Zoev89/Draaischijf/StepperDriver/Pololu - A4988 Stepper Motor Driver Carrier_files/0J4577.300.jpg

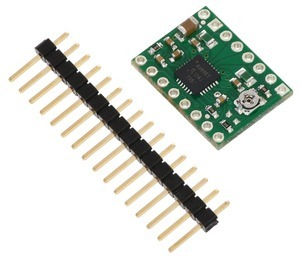
StepperDriver/Pololu - A4988 Stepper Motor Driver Carrier_files/0J4577.300.jpg
