Zoev89/Draaischijf/StepperDriver/Pololu - A4988 Stepper Motor Driver Carrier_files/0J1418.250.jpg

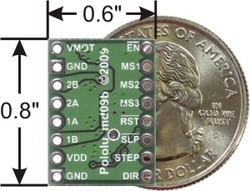
StepperDriver/Pololu - A4988 Stepper Motor Driver Carrier_files/0J1418.250.jpg
