Zoev89/Draaischijf/StepperDriver/Pololu - A4988 Stepper Motor Driver Carrier_files/0J4578.180.jpg

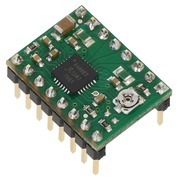
StepperDriver/Pololu - A4988 Stepper Motor Driver Carrier_files/0J4578.180.jpg
