Zoev89/Draaischijf/huis.stl

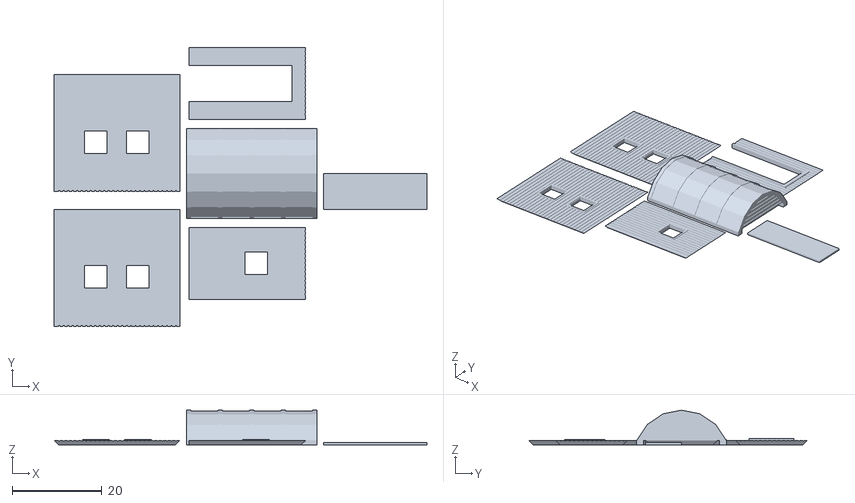
[picture p4: CAD file, 2016-03-12]
huis.stl
83.0 x 62.0 x 7.70
