Zoev89/Draaischijf/onderkant.stl

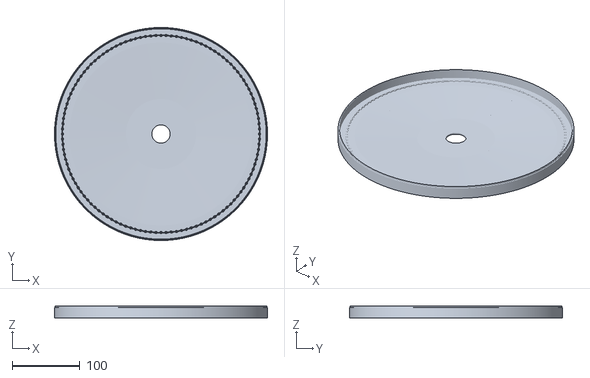
[picture p5: CAD file, 2016-03-12]
onderkant.stl
314.0 x 314.0 x 17.0
