Zoev89/Draaischijf/trap.stl

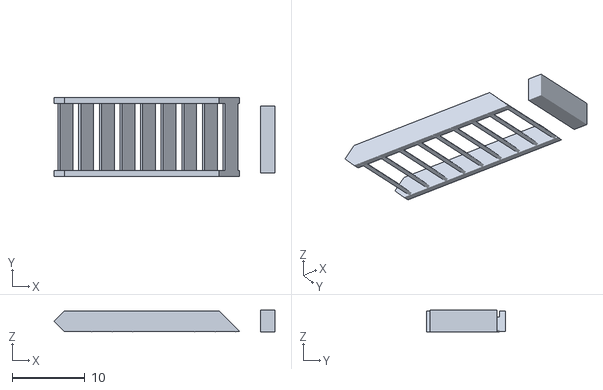
[picture p6: CAD file, 2016-03-12]
trap.stl
30.3 x 10.8 x 3.00
