Zoev89/Draaischijf/groteTandwiel.stl

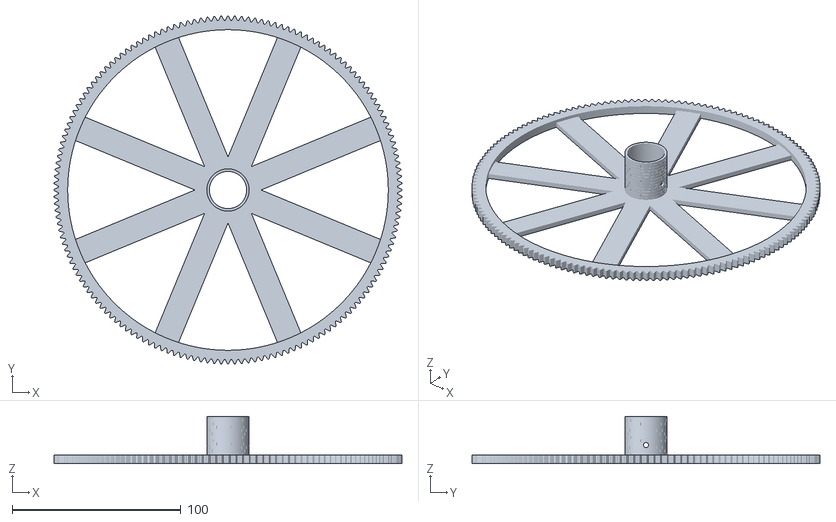
[picture p7: CAD file, 2016-03-12]
groteTandwiel.stl
206.3 x 206.3 x 28.0
