Zoev89/Draaischijf/platformRails.stl

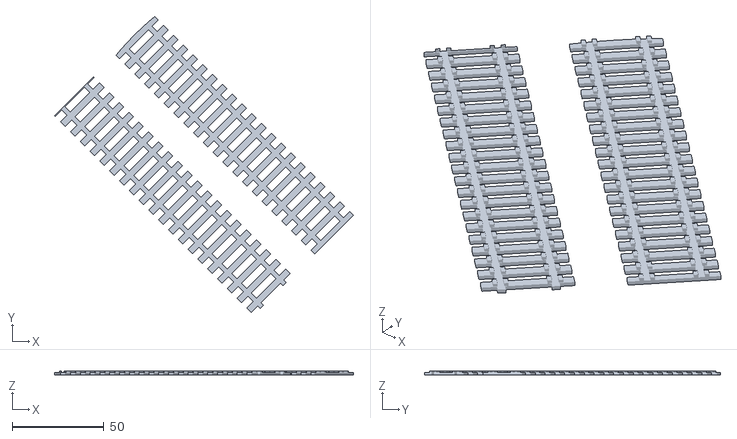
[picture p8: CAD file, 2016-03-12]
platformRails.stl
163.1 x 161.5 x 2.30
