Zoev89/Draaischijf/groteLigger.stl

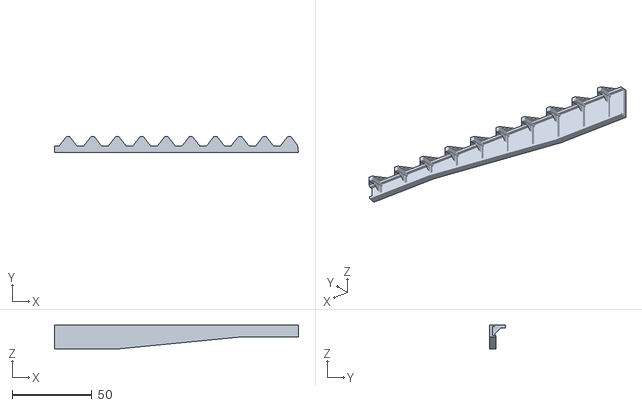
[picture p9: CAD file, 2016-03-12]
groteLigger.stl
152.9 x 10.0 x 15.0
