Zoev89/Draaischijf/motorSteun.stl

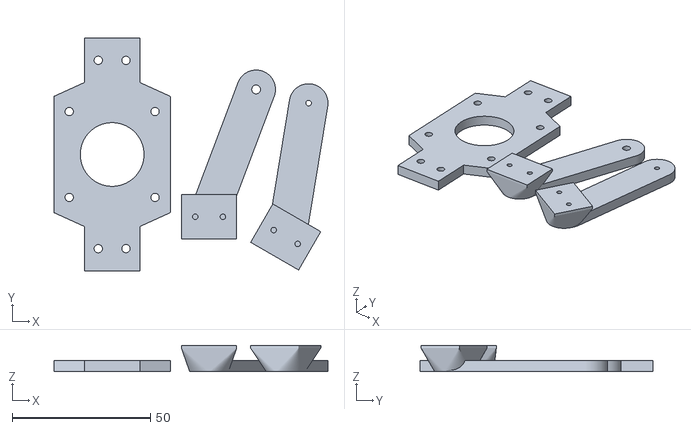
[picture p10: CAD file, 2016-03-12]
motorSteun.stl
99.0 x 84.0 x 9.50
