Zoev89/Draaischijf/tandKlem.stl

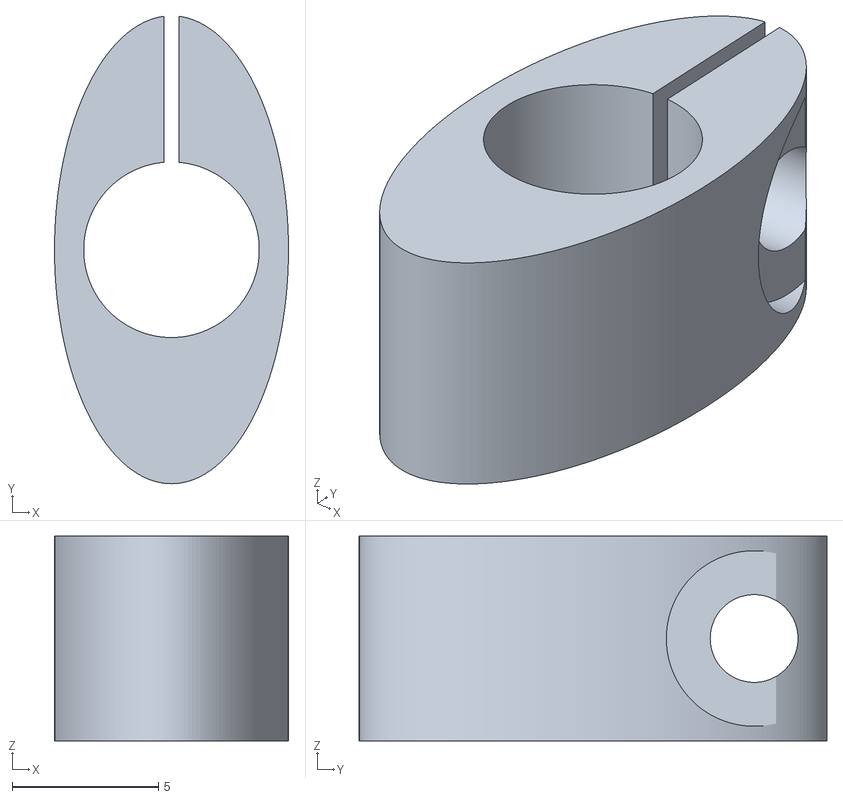
[picture p11: CAD file, 2016-03-12]
tandKlem.stl
8.00 x 16.0 x 7.00
