Zoev89/Draaischijf/steuntjes.stl

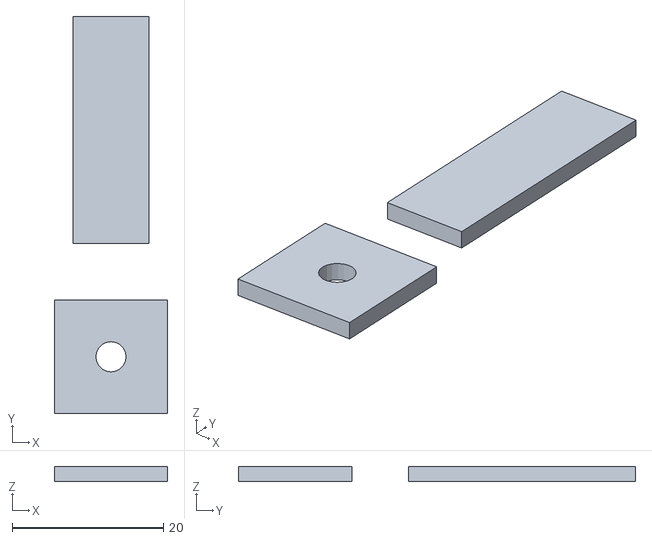
[picture p12: CAD file, 2016-03-12]
steuntjes.stl
15.0 x 52.5 x 2.00
