Zoev89/Draaischijf/pootjes.stl

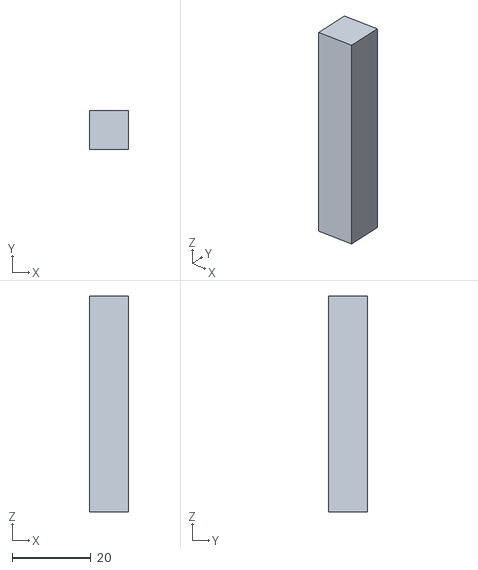
[picture p13: CAD file, 2016-03-12]
pootjes.stl
10.0 x 10.0 x 55.0
