Zoev89/Draaischijf/onderPlaat.stl

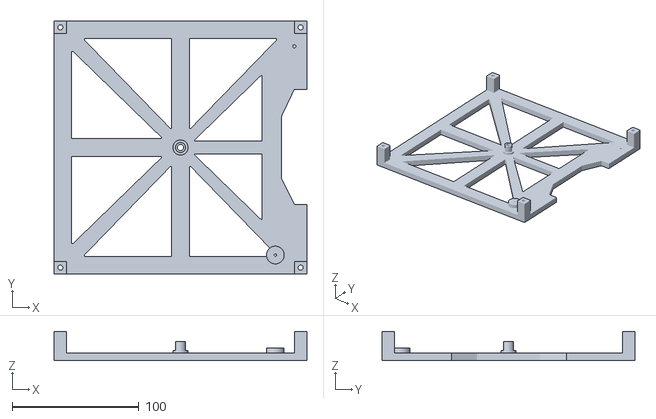
[picture p14: CAD file, 2016-03-12]
onderPlaat.stl
200.0 x 200.0 x 23.0
