Zoev89/Draaischijf/railsDeksel.stl

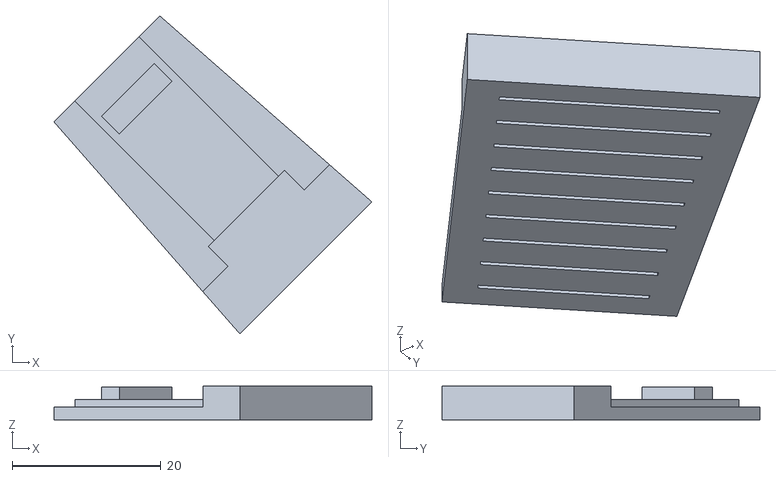
[picture p15: CAD file, 2016-03-12]
railsDeksel.stl
42.7 x 42.7 x 4.50
