Zoev89/Draaischijf/binnenkant.stl

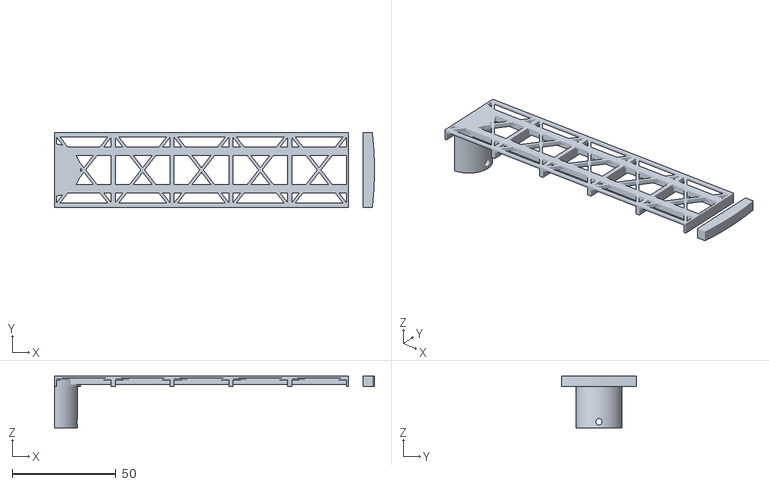
[picture p16: CAD file, 2016-03-12]
binnenkant.stl
154.0 x 36.0 x 25.0
