Zoev89/Draaischijf/BevestigingsRing.stl

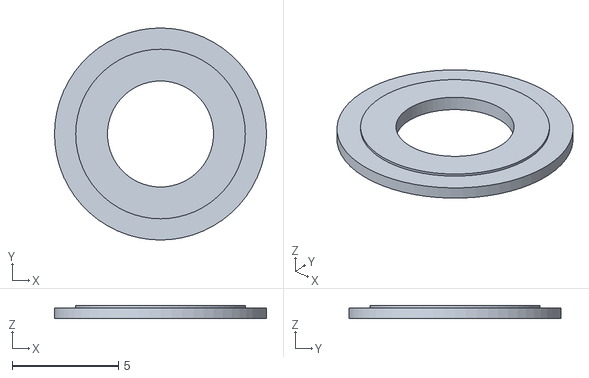
[picture p17: CAD file, 2016-03-12]
BevestigingsRing.stl
10.0 x 10.0 x 0.6
