Zoev89/Draaischijf/railing.stl

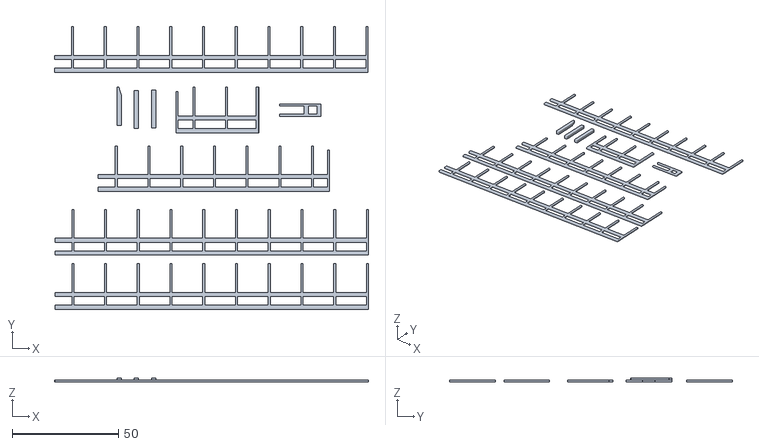
[picture p18: CAD file, 2016-03-12]
railing.stl
147.7 x 133.0 x 2.00
