Zoev89/Draaischijf/kleineTandwiel.stl

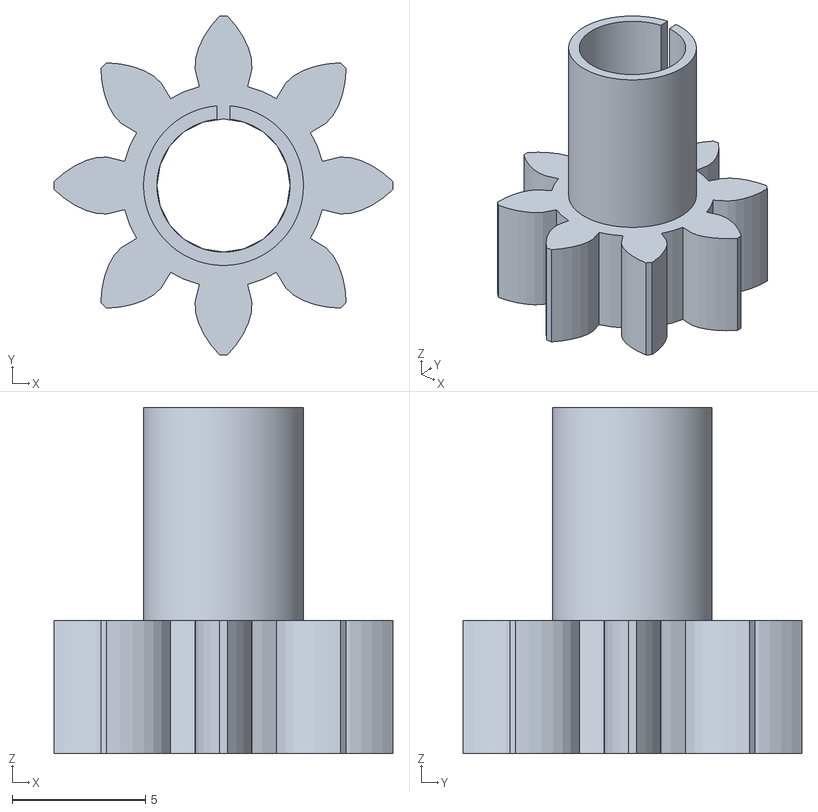
[picture p19: CAD file, 2016-03-12]
kleineTandwiel.stl
12.7 x 12.7 x 13.0
