Zoev89/Draaischijf/bodemPlanken.stl

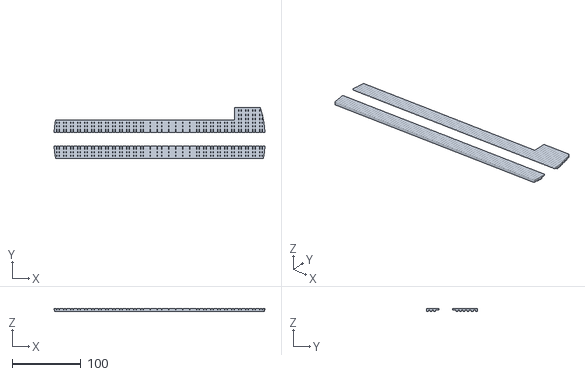
[picture p20: CAD file, 2016-03-12]
bodemPlanken.stl
307.3 x 74.0 x 4.00
