Zoev89/Draaischijf/railsAansluiting.stl

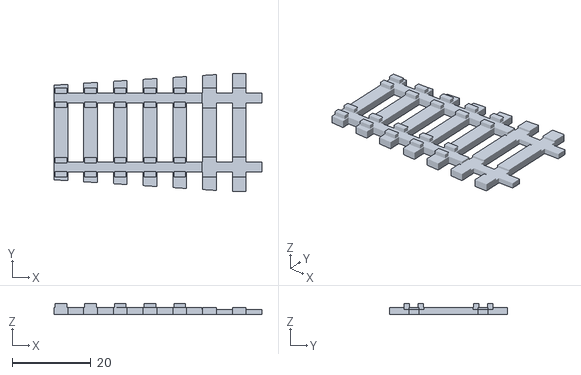
[picture p21: CAD file, 2016-03-12]
railsAansluiting.stl
52.9 x 30.0 x 2.80
