Zoev89/Draaischijf/(threads)

Thread 1 (2023-10-13):

Turntable

derDoc2023, 2023-10-13:
Hello,
The turntable is interesting.

What length of locomotive can be parked there?

Zoev89, 2023-10-14:
The length is 30.5mm. The locomotive could be larger but its weels must fit withing the 30.5mm otherwise it can not turn.

derDoc2023, 2023-10-16:
Thanks for the info. It's a nice template. Unfortunately, many things don't fit on my print bed. And since I don't really know much about OPENCAD, it's a bit difficult. I already have your locomotive shed in print. Also a wonderful template!

Are all round parts also available as 1/4 parts?

Zoev89, 2023-10-16:
The big bottom part is in 4 parts. My printer bed can not hold 30cm part. I have a ultimaker orgininal and its bed is a little over 20cm. Max 21cm if I am not wrong.

derDoc2023, 2023-10-17:
Hey,

I have an Ender V3 Neo, the print bed is 25cm. I also found the file with the quarter pieces. But I can't print it like that. Because neither my Crealty Slicer nor Cura deletes the other parts.

Because I think your design is really great and would really like to use it.

I've already printed your engine shed. It's also great and can be used modularly.

Zoev89, 2023-10-17:
In the source file you can comment out any part that you don't want to
print at that time. Select one part generate the stl and print. With a
printer bed of 25cm you can do it. Mine is smaller:)

Op di 17 okt. 2023 05:57 schreef derDoc2023 ***@***.***>:

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

derDoc2023, 2023-10-17:
Thank you!

I'm such an idiot for not seeing that.

But one more thing, do you have instructions on how exactly you put something together? Because some things are not entirely clear to me.

Unfortunately there is nothing in the download.

I will control the turntable with an Arduino. I would be happy to send you a little information about how I did it and I can send you photos if you want.

Greetings from Bischofswerda

Zoev89, 2023-10-18:
Did you also see the images on youmagine?

[https://www.youmagine.com/designs/h0-train-turntable](url)

What do you mean by the download. All the files are here on the github.
In the electronics I used a atmega8 which is actually the same chip to be found on some of the ardruino's. For the steppenmotor driver I used the baseclock of my railway electronics which is a 28000 baudrate from the uart. So there you have to create something yourself. You can also use a simple clock and readin some input lines to form the position and then let it run to that position. Could be as simple as that. In my case the turntable also provides the power for the track that is in the locomotive shed.

Zoev89, 2023-10-18:
Did you also found this site:
[https://zoev89.github.io/draaiSchijf/index.html](url)
Sort of the same info but there are some extra fotoos.

Greetings from Waalre

derDoc2023, 2023-10-19:
Good morning,

// -> What do you mean by download? All files are here on Github.
I found the print template via https://thangs.com/search/h0?scope=all.

I plan to control the turntable via an Arduino. Offers itself. I will probably solve the approach to the positions with reed contacts and a magnet. I have to test it.

In the photos you solved it with cables on the king chair. I try to design the rotation movement so that I don't have to pay attention to the cables. Because these can also become over-tightened and defective at some point. I test the whole thing with Holplugs and sockets. Since I drive digitally and the amps also have to run through the plugs.

-> https://www.amazon.de/RUNCCI-YUN-DC-Hohlstecker-L%C3%B6tleitung-DC-Stecker%EF%BC%88Mit-%C3%9Cberwachungskameras/dp/B0836N82PR/

What did you use to solve the king chair running on the base plate? What kind of wheels are these, with or without ball bearings and where can I get them? I did a search, but I needed the diameter of the wheels.

Zoev89, 2023-10-21:
The wheels are small bearings but I did not specify the size. I looked in
the scad files and it turns out to be 8mm diameter and 3mm inner dia.

Actually I never posted on thangs.com so that is maybe why the download is
not complete.

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
