Zoev89/Draaischijf/DraaiBoard/DraaiBoard.sch

## KiCad design DraaiBoard/DraaiBoard.sch (2016-04-03)

Schematic: DraaiBoard.sch

Parts:
C1, C2: 22pF
C3: 100uF
C4: 100nF
D1, D2, D3, D4: ZENER 2V7
D5, D6, D7, D8, D9, D10, D11, D12, D13, D14: DIODE
IC1: ATMEGA8A-P; DIL28
J1: DB25
K1, K2, K3, K4, K5, K6, K7, K8, K9: RELAY_2RT
P1: CONN_5X2
Q1: BD680; TO220
Q2: BD679; TO220
Q3, Q5, Q7, Q8, Q9, Q10, Q11, Q12, Q13, Q14, Q15: BC546; TO92
Q4, Q6: BC556; TO92
R1, R2: 0.39
R3, R6: 33K
R4: 132E
R5: 100K
R7, R9, R11, R12, R13, R14, R15, R16, R17, R18, R19, R20, R21, R22, R23, R25, R26, R27: 10K
R8: 8k2
R10: 100E
R24: 2.2K
R28: 1K
U1: 7805
U2: 74LS138
U3: POLOLU_A4988
U4: 74LS240
U5: C96ABC
X1: Crystal 14.7456MHz

Notes on the sheet:
Draad Zwart Groen
Draad Blauw Zwart
rood
zwart
