Zoev89/Draaischijf/DraaiSchijfController/pulseTable.h

const uint8_t pulseTabel[64][8] PROGMEM =
{
    {0b00000000, 0b00000000, 0b00000000, 0b00000000, 0b00000000, 0b00000000, 0b00000000, 0b00000000}, // 0
    {0b00000000, 0b00000000, 0b00000000, 0b00000000, 0b00000000, 0b00000000, 0b00000000, 0b00000000}, // 1
    {0b00000000, 0b00000000, 0b00000000, 0b00000000, 0b00000000, 0b00000000, 0b00000000, 0b00000000}, // 2
    {0b00000011, 0b00000000, 0b00000000, 0b00000000, 0b00000001, 0b00000000, 0b00000000, 0b00000000}, // 3
    {0b00000011, 0b00000000, 0b00000000, 0b00000000, 0b00000011, 0b00000000, 0b00000000, 0b00000000}, // 4
    {0b00000111, 0b00000000, 0b00000000, 0b00000000, 0b00000011, 0b00000000, 0b00000000, 0b00000000}, // 5
    {0b00000111, 0b00000000, 0b00000000, 0b00000000, 0b00000111, 0b00000000, 0b00000000, 0b00000000}, // 6
    {0b00001111, 0b00000000, 0b00000000, 0b00000000, 0b00000111, 0b00000000, 0b00000000, 0b00000000}, // 7
    {0b00001111, 0b00000000, 0b00000000, 0b00000000, 0b00001111, 0b00000000, 0b00000000, 0b00000000}, // 8
    {0b00011111, 0b00000000, 0b00000000, 0b00000000, 0b00001111, 0b00000000, 0b00000000, 0b00000000}, // 9
    {0b00011111, 0b00000000, 0b00000000, 0b00000000, 0b00011111, 0b00000000, 0b00000000, 0b00000000}, // 10
    {0b00111111, 0b00000000, 0b00000000, 0b00000000, 0b00011111, 0b00000000, 0b00000000, 0b00000000}, // 11
    {0b00111111, 0b00000000, 0b00000000, 0b00000000, 0b00111111, 0b00000000, 0b00000000, 0b00000000}, // 12
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
    {0b11111111, 0b11111111, 0b00000111, 0b00000000, 0b11111111, 0b11111111, 0b00000111, 0b00000000}, // 38
    {0b11111111, 0b11111111, 0b00001111, 0b00000000, 0b11111111, 0b11111111, 0b00000111, 0b00000000}, // 39
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
};
