Zoev89/Draaischijf/(commit log)

2016-03-12 draaischijf scad files
    [draaiPlatform.scad, gear.scad, tandwielen.scad]
2016-03-12 Add stl files
    [BevestigingsRing.stl, binnenkant.stl, bodemPlanken.stl, groteLigger.stl, groteTandwiel.stl, huis.stl, kleineTandwiel.stl, motorSteun.stl]
2016-03-12 Add board design + doc
    [DraaiBoard.sch]
2016-04-03 Spanning detectie van aan nu correct. De ad convert werd telaat gestart waardoor de uitgang al tijdens sample en hold veranderde. Programeren van de eeprom liep fout want het duurd zolang dat de watc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
    [main.c]
2016-04-03 Homing aangepast zodat die iets terug draaid als die op het reedcontact staat. + Middendetect aan en uit seperaat
    [DraaiBoard.sch]
2018-01-02 Use unused pc5 bit to connect a ground output for a light output. In my case a locomotive shed
    [draaiPlatform.scad]
